Bluebird-Aerospace/versor-lite/kicad_files/versorlite.kicad_pcb

## KiCad design kicad_files/versorlite.kicad_pcb (2026-05-29)

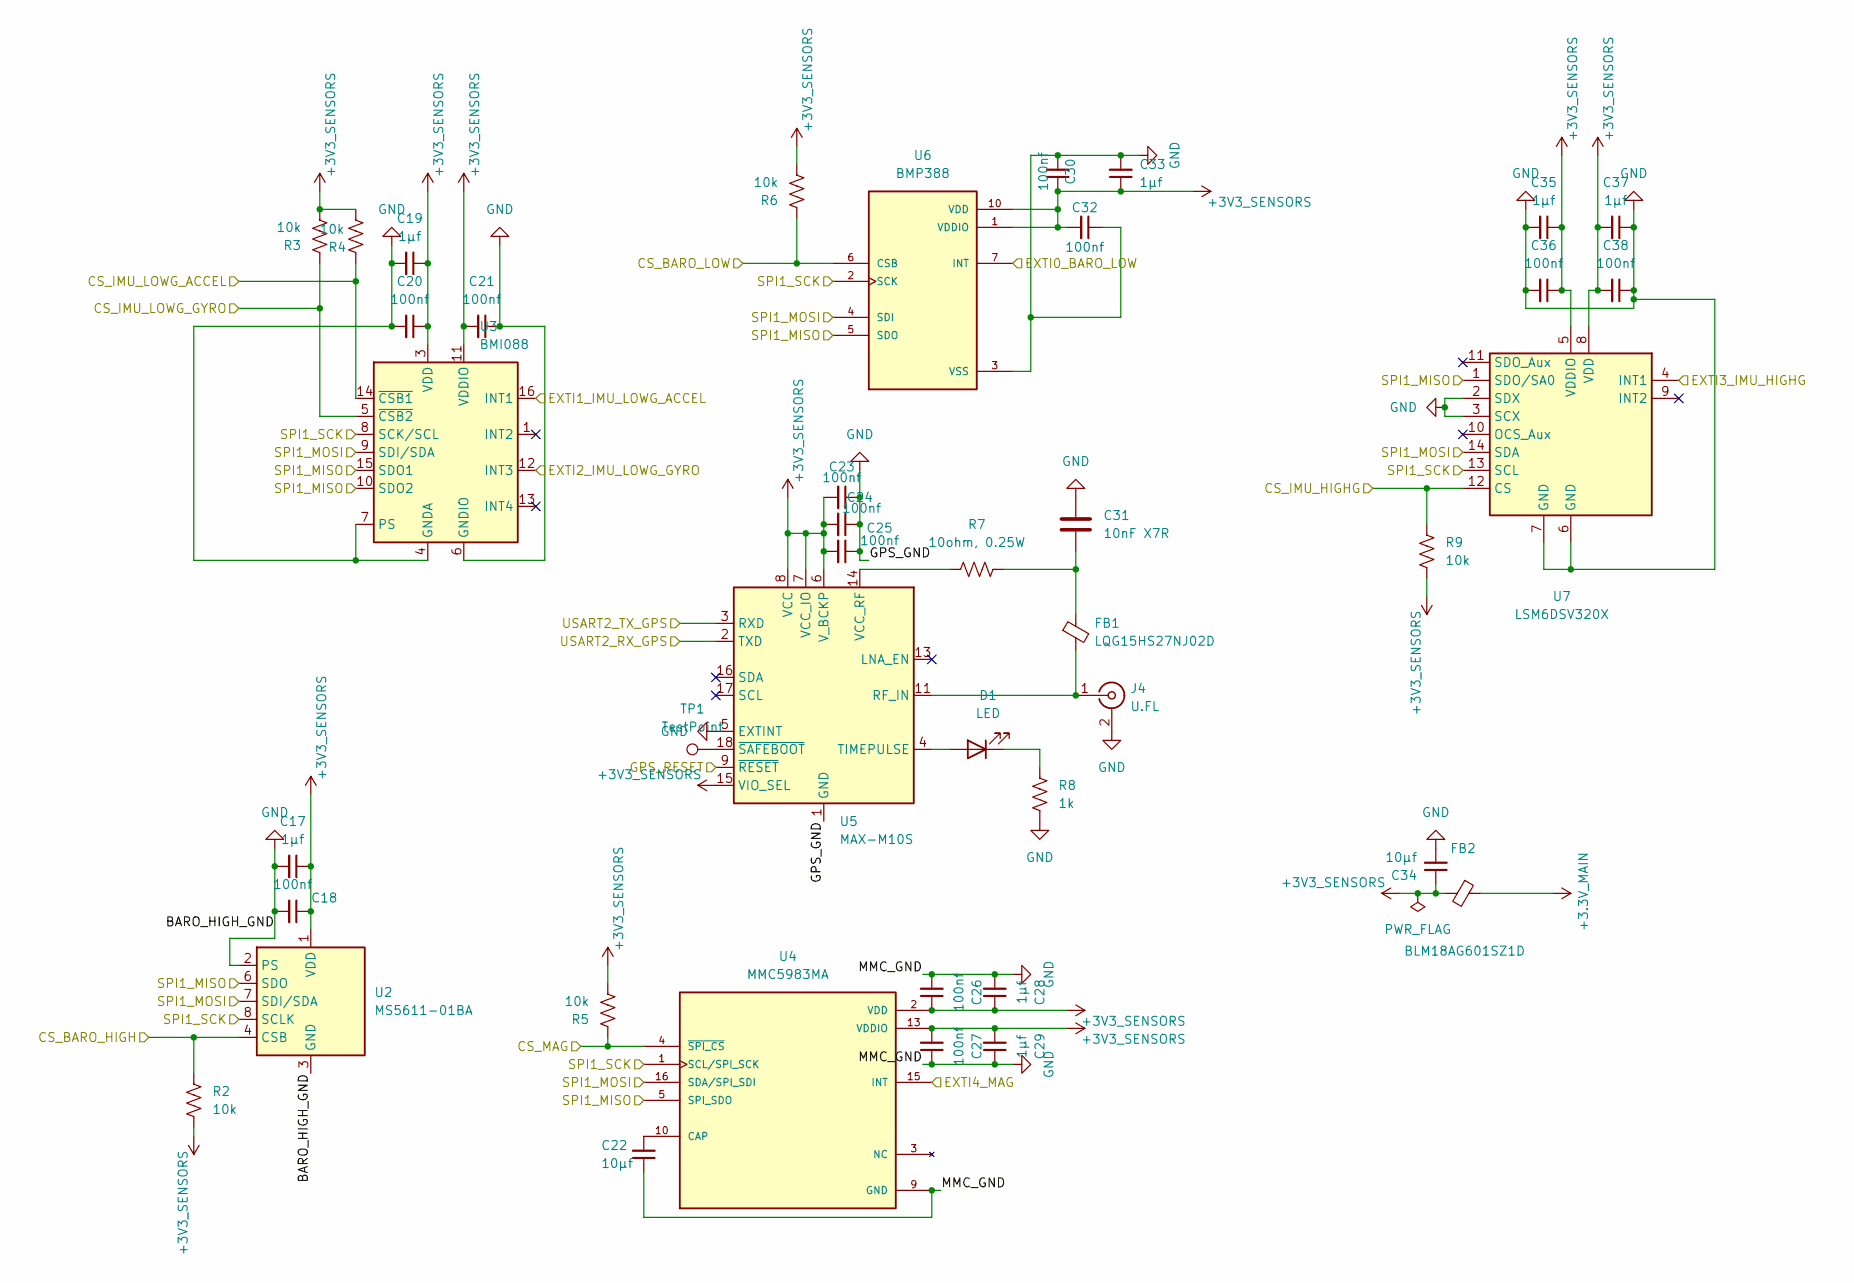
[picture p1: schematic sensors.kicad_sch]

Parts:
C17, C19, C28, C29, C33, C35, C37: 1μf; C_0402_1005Metric
C18, C20, C21, C23, C24, C25, C26, C27, C30, C32, C36, C38: 100nf; C_0402_1005Metric
C22, C34: 10μf; C_0805_2012Metric
C31: 10nF X7R; C_0402_1005Metric
D1: LED; LED_0603_1608Metric
FB1: LQG15HS27NJ02D; L_0402_1005Metric
FB2: BLM18AG601SZ1D; L_0603_1608Metric
J4: U.FL; U.FL_Hirose_U.FL-R-SMT-1_Vertical; LCSC C5137195
R2, R3, R4, R5, R6, R9: 10k; R_0402_1005Metric
R7: 10ohm, 0.25W; R_1206_3216Metric
R8: 1k; R_0603_1608Metric
TP1: TestPoint; TestPoint_Pad_D1.0mm
U2: MS5611-01BA; LGA-8_3x5mm_P1.25mm
U3: BMI088; Bosch_LGA-16_4.5x3mm_P0.5mm_LayoutBorder7x1y_ClockwisePinNu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
U4: MMC5983MA; PQFN50P300X300X100-16N; PARTREV A
U5: MAX-M10S; ublox_MAX
U6: BMP388; PARTREV 1.1
U7: LSM6DSV320X; LGA-14_3x2.5mm_P0.5mm_LayoutBorder3x4y

Connections:
+3.3V_MAIN: FB2.1; also elsewhere on the board
+3V3_SENSORS: C17.1, C18.1, C19.1, C20.1, C21.2, C23.2, C24.2, C25.2, C26.1, C27.2, C28.1, C29.2, C30.1, C32.2, C33.1, C34.1, C35.1, C36.1, C37.2, C38.2, FB2.2, R2.2, R3.2, R4.2, R5.2, R6.2, R9.2, U2.1 (VDD), U3.3 (VDD), U3.11 (VDDIO), U4.2 (VDD), U4.13 (VDDIO), U5.6 (V_BCKP), U5.7 (VCC_IO), U5.8 (VCC), U5.15 (VIO_SEL), U6.1 (VDDIO), U6.10 (VDD), U7.5 (VDDIO), U7.8 (VDD)
/MCU/CS_BARO_HIGH: R2.1, U2.4 (CSB), U2.5 (CSB); also elsewhere on the board
/MCU/CS_BARO_LOW: R6.1, U6.6 (CSB); also elsewhere on the board
/MCU/CS_IMU_HIGHG: R9.1, U7.12 (CS); also elsewhere on the board
/MCU/CS_IMU_LOWG_ACCEL: R4.1, U3.14 (~CSB1); also elsewhere on the board
/MCU/CS_IMU_LOWG_GYRO: R3.1, U3.5 (~CSB2); also elsewhere on the board
/MCU/CS_MAG: R5.1, U4.4 (~SPI_CS); also elsewhere on the board
/MCU/EXTI0_BARO_LOW: U6.7 (INT); also elsewhere on the board
/MCU/EXTI1_IMU_LOWG_ACCEL: U3.16 (INT1); also elsewhere on the board
/MCU/EXTI2_IMU_LOWG_GYRO: U3.12 (INT3); also elsewhere on the board
/MCU/EXTI3_IMU_HIGHG: U7.4 (INT1); also elsewhere on the board
/MCU/EXTI4_MAG: U4.15 (INT); also elsewhere on the board
/MCU/GPS_RESET: U5.9 (~RESET); also elsewhere on the board
/MCU/SPI1_MISO: U2.6 (SDO), U3.10 (SDO2), U3.15 (SDO1), U4.5 (SPI_SDO), U6.5 (SDO), U7.1 (SDO/SA0); also elsewhere on the board
/MCU/SPI1_MOSI: U2.7 (SDI/SDA), U3.9 (SDI/SDA), U4.16 (SDA/SPI_SDI), U6.4 (SDI), U7.14 (SDA); also elsewhere on the board
/MCU/SPI1_SCK: U2.8 (SCLK), U3.8 (SCK/SCL), U4.1 (SCL/SPI_SCK), U6.2 (SCK), U7.13 (SCL); also elsewhere on the board
/MCU/USART2_RX_GPS: U5.2 (TXD); also elsewhere on the board
/MCU/USART2_TX_GPS: U5.3 (RXD); also elsewhere on the board
GND: C17.2, C18.2, C19.2, C20.2, C21.1, C22.1, C23.1, C24.1, C25.1, C26.2, C27.1, C28.2, C29.1, C30.2, C31.1, C32.1, C33.2, C34.2, C35.2, C36.2, C37.1, C38.1, J4.2 (Ext), R8.2, U2.2 (PS), U2.3 (GND), U3.2 (GNDA), U3.4 (GNDA), U3.6 (GNDIO), U3.7 (PS), U4.9 (GND), U4.11 (GND), U5.1 (GND), U5.5 (EXTINT), U5.10 (GND), U5.12 (GND), U6.3 (VSS), U6.8 (VSS), U6.9 (VSS), U7.2 (SDX), U7.3 (SCX), U7.6 (GND), U7.7 (GND); also elsewhere on the board
unnamed: C31.2, FB1.1, R7.2
unnamed: D1.2 (A), U5.4 (TIMEPULSE)
unnamed: D1.1 (K), R8.1
unnamed: FB1.2, J4.1 (In), U5.11 (RF_IN)
unnamed: C22.2, U4.10 (CAP)
unnamed: R7.1, U5.14 (VCC_RF)
unnamed: TP1.1 (1_1), U5.18 (~SAFEBOOT)

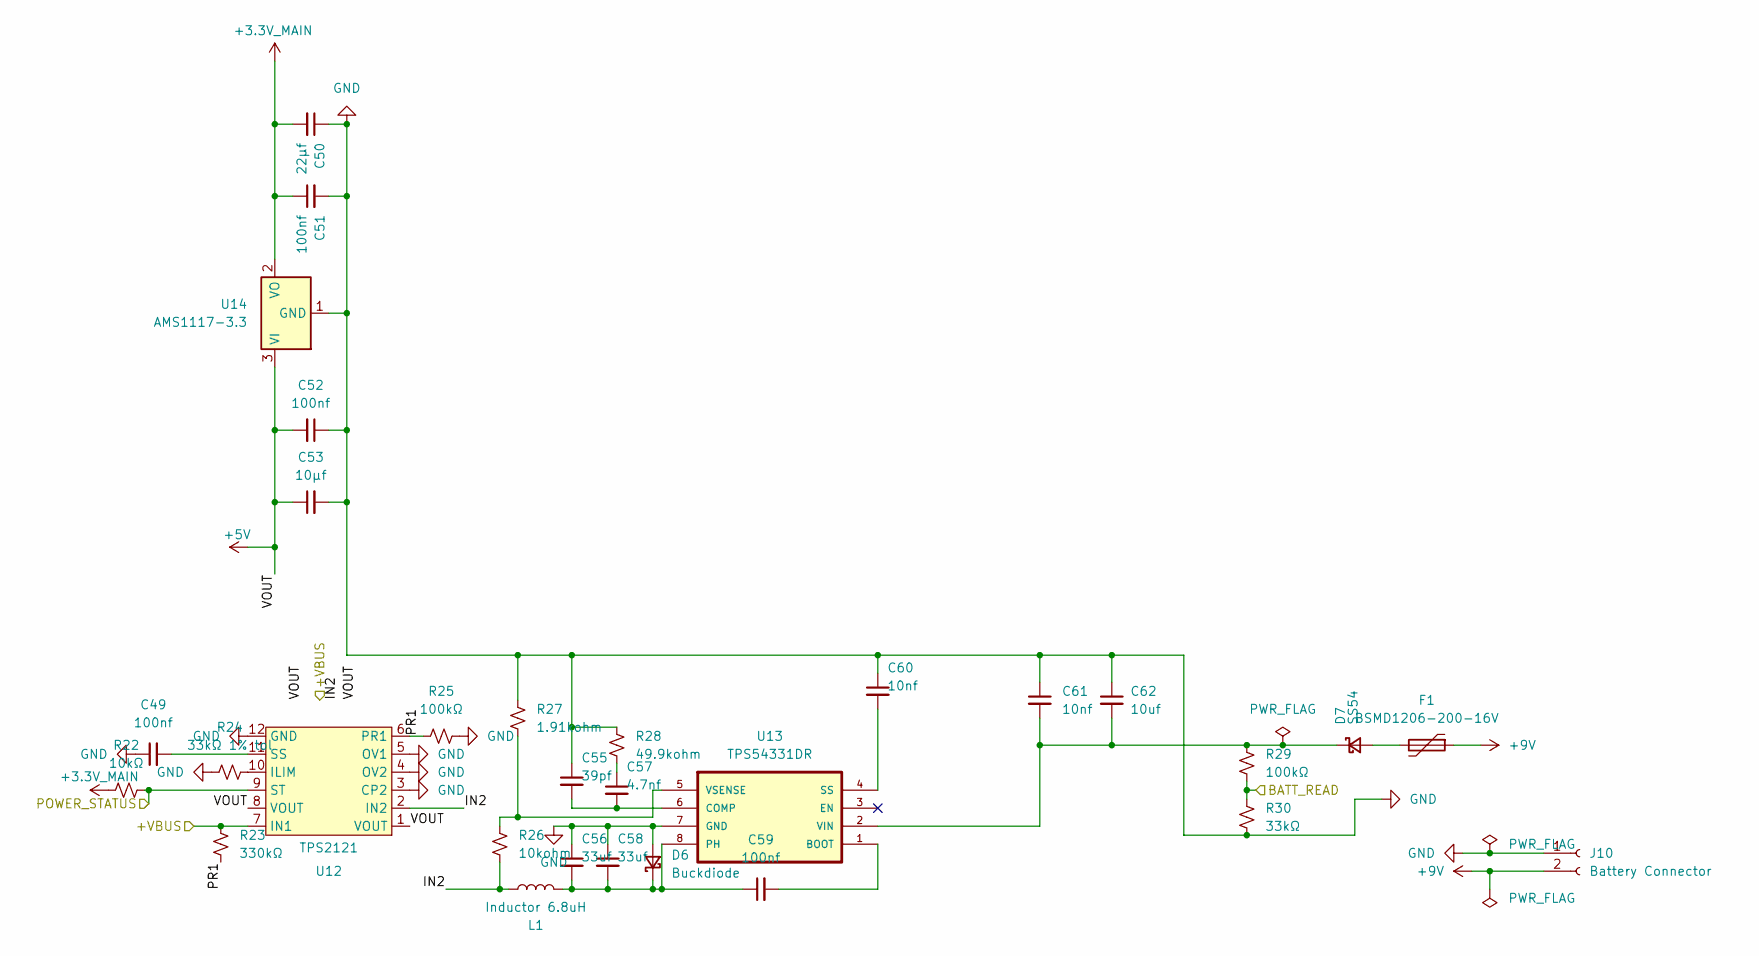
[picture p2: schematic power.kicad_sch]

Parts:
C49, C51, C52, C59: 100nf; C_0402_1005Metric
C50: 22μf; C_0805_2012Metric
C53: 10μf; C_0805_2012Metric
C55: 39pf; C_0402_1005Metric
C56, C58: 33uf; C_0805_2012Metric
C57: 4.7nf; C_0402_1005Metric
C60, C61: 10nf; C_0402_1005Metric
C62: 10uf; C_0805_2012Metric
D6: Buckdiode; D_SMA
D7: SS54; D_SMA
F1: BSMD1206-200-16V; Fuse_1206_3216Metric
J10: Battery Connector; AMASS_XT30U-F_1x02_P5.0mm_Vertical
L1: Inductor 6.8uH; L_Coilcraft_XxL4030
R22: 10kΩ; R_0402_1005Metric
R23: 330kΩ; R_0402_1005Metric
R24: 33kΩ 1% tol; R_0402_1005Metric
R25: 100kΩ; R_0402_1005Metric
R26: 10kohm; R_0402_1005Metric
R27: 1.91kohm; R_0402_1005Metric
R28: 49.9kohm; R_0402_1005Metric
R29: 100kΩ; R_0603_1608Metric
R30: 33kΩ; R_0603_1608Metric
U12: TPS2121; IC_TPS2121RUXR
U13: TPS54331DR; SOIC127P599X175-8N
U14: AMS1117-3.3; SOT-223-3_TabPin2

Connections:
+3.3V_MAIN: C50.2, C51.1, R22.1, U14.2 (VO); also elsewhere on the board
+5V: C52.2, C53.1, U12.1 (VOUT), U12.1_1 (TV), U12.8 (VOUT), U12.8_1 (TV), U14.3 (VI); also elsewhere on the board
+9V: F1.1, J10.2; also elsewhere on the board
/MCU/BATT_READ: R29.2, R30.1; also elsewhere on the board
/MCU/POWER_STATUS: R22.2, U12.9 (ST); also elsewhere on the board
/Power/+VBUS: R23.2, U12.7 (IN1), U12.7_1 (TV); also elsewhere on the board
/Power/IN2: L1.1, R26.2, U12.2 (IN2), U12.2_1 (TV)
/Power/PR1: R23.1, R25.1, U12.6 (PR1)
GND: C49.1, C50.1, C51.2, C52.1, C53.2, C55.1, C56.1, C58.1, C60.1, C61.1, C62.1, D6.2 (A), J10.1, R24.1, R25.2, R27.1, R28.1, R30.2, U12.3 (CP2), U12.4 (OV2), U12.5 (OV1), U12.12 (GND), U13.7 (GND), U14.1 (GND); also elsewhere on the board
unnamed: C57.1, R28.2
unnamed: C56.2, C58.2, C59.1, D6.1 (K), L1.2, U13.8 (PH)
unnamed: D7.2 (A), F1.2
unnamed: C61.2, C62.2, D7.1 (K), R29.1, U13.2 (VIN)
unnamed: R24.2, U12.10 (ILIM)
unnamed: C49.2, U12.11 (SS)
unnamed: C59.2, U13.1 (BOOT)
unnamed: C55.2, C57.2, U13.6 (COMP)
unnamed: C60.2, U13.4 (SS)
unnamed: R26.1, R27.2, U13.5 (VSENSE)

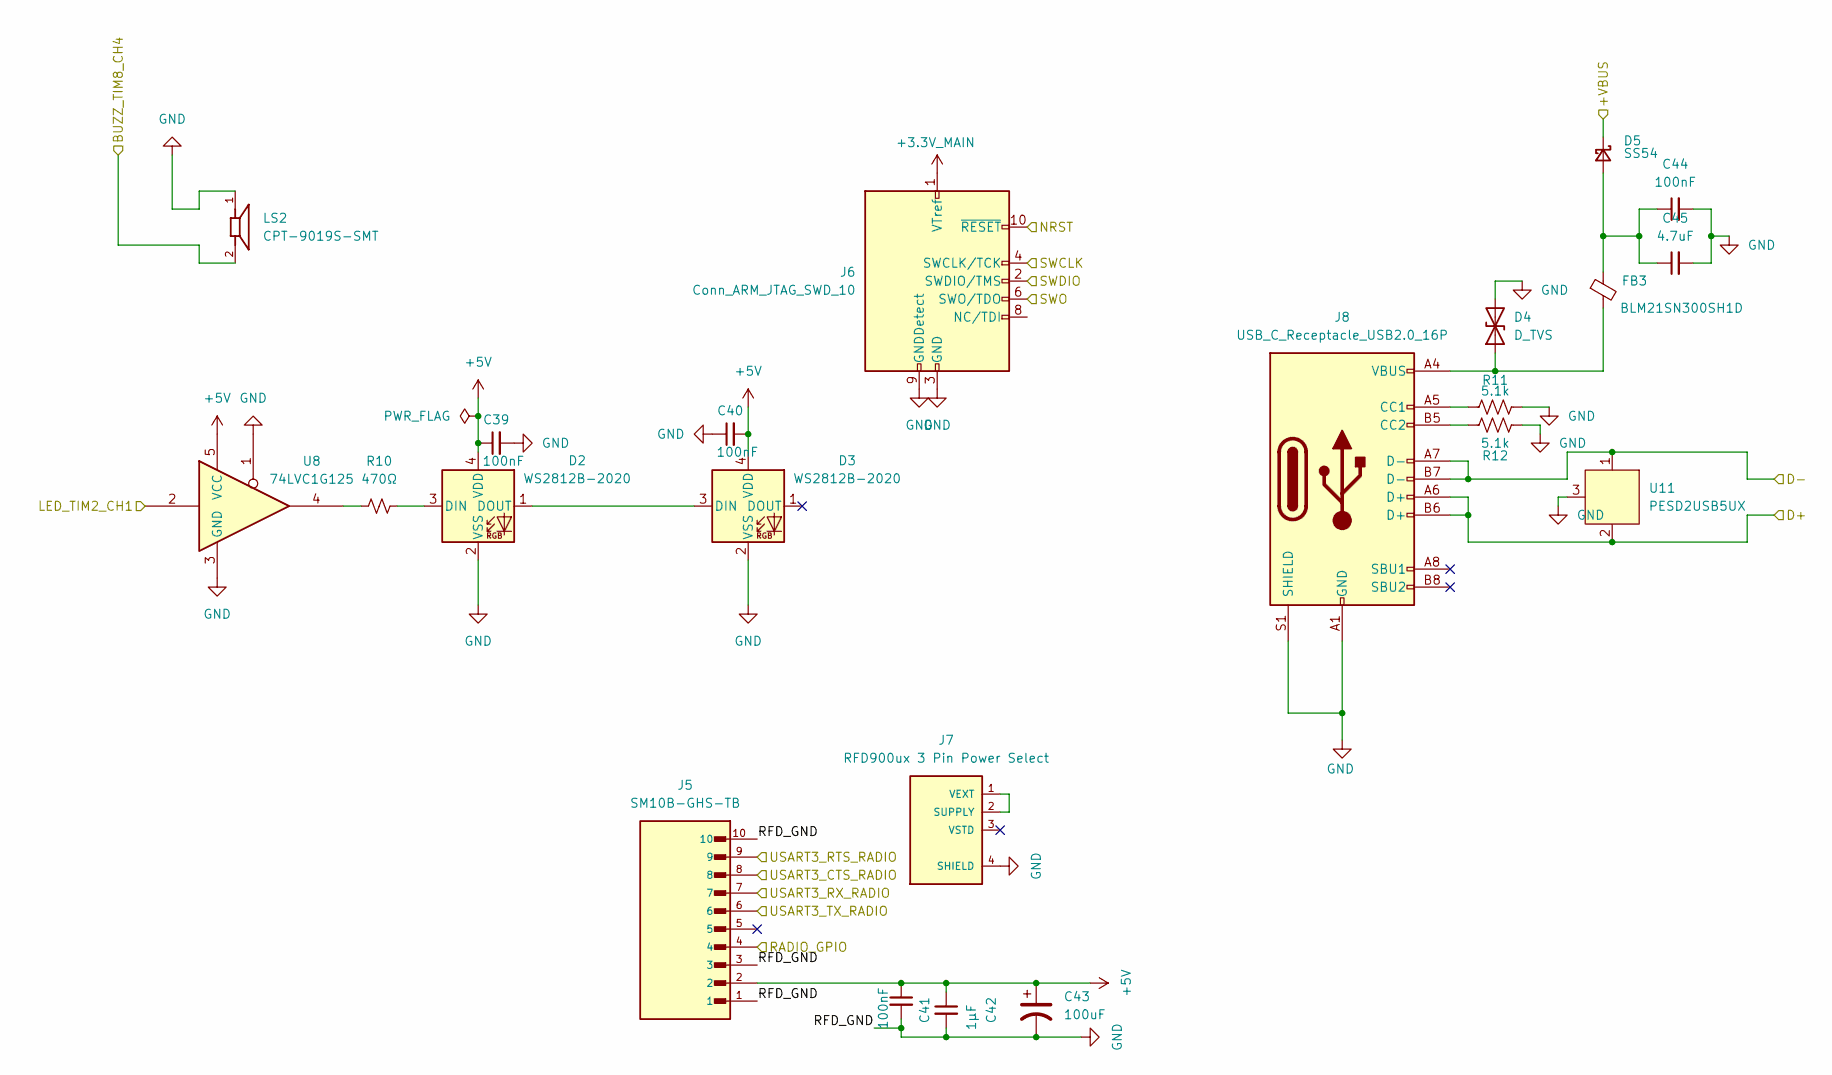
[picture p3: schematic telemetry.kicad_sch]

Parts:
C39, C40, C41, C44: 100nF; C_0402_1005Metric
C42: 1μF; C_0402_1005Metric
C43: 100uF; CP_EIA-3528-21_Kemet-B
C45: 4.7uF; C_0603_1608Metric
D2, D3: WS2812B-2020; LED_WS2812B-2020_PLCC4_2.0x2.0mm
D4: D_TVS; D_SOD-882
D5: SS54; D_SMA
FB3: BLM21SN300SH1D; L_0805_2012Metric
J5: SM10B-GHS-TB; JST_SM10B-GHS-TB
J6: Conn_ARM_JTAG_SWD_10; PinHeader_2x05_P1.27mm_Vertical
J7: RFD900ux 3 Pin Power Select; CONN_BM03B-GHS-TBT_LF__SN__N_
J8: USB_C_Receptacle_USB2.0_16P; USB_C_Receptacle_GCT_USB4105-xx-A_16P_TopMnt_Horizontal
LS2: CPT-9019S-SMT; CUI_CPT-9019S-SMT; PART_REV 1.0
R10: 470Ω; R_0402_1005Metric
R11, R12: 5.1k; R_0402_1005Metric
U8: 74LVC1G125; SOT-23-5
U11: PESD2USB5UX; TSOT-23

Connections:
+3.3V_MAIN: J6.1 (VTref); also elsewhere on the board
+5V: C39.1, C40.2, C41.1, C42.1, C43.1, D2.4 (VDD), D3.4 (VDD), J5.2, U8.5 (VCC); also elsewhere on the board
/MCU/BUZZ_TIM8_CH4: LS2.2; also elsewhere on the board
/MCU/D+: J8.A6 (D+), J8.B6 (D+), U11.2; also elsewhere on the board
/MCU/D-: J8.A7 (D-), J8.B7 (D-), U11.1; also elsewhere on the board
/MCU/LED_TIM2_CH1: U8.2; also elsewhere on the board
/MCU/NRST: J6.10 (~RESET); also elsewhere on the board
/MCU/RADIO_GPIO: J5.4; also elsewhere on the board
/MCU/SWCLK: J6.4 (SWCLK/TCK); also elsewhere on the board
/MCU/SWDIO: J6.2 (SWDIO/TMS); also elsewhere on the board
/MCU/SWO: J6.6 (SWO/TDO); also elsewhere on the board
/MCU/USART3_CTS_RADIO: J5.8; also elsewhere on the board
/MCU/USART3_RTS_RADIO: J5.9; also elsewhere on the board
/MCU/USART3_RX_RADIO: J5.7; also elsewhere on the board
/MCU/USART3_TX_RADIO: J5.6; also elsewhere on the board
/Power/+VBUS: D5.1 (K); also elsewhere on the board
GND: C39.2, C40.1, C41.2, C42.2, C43.2, C44.2, C45.2, D2.2 (VSS), D3.2 (VSS), D4.2 (A2), J5.1, J5.3, J5.10, J6.3 (GND), J6.5 (GND), J6.9 (GNDDetect), J7.4 (SHIELD), J7.5 (SHIELD), J8.A1 (GND), J8.A12 (GND), J8.B1 (GND), J8.B12 (GND), J8.S1 (SHIELD), LS2.1, R11.2, R12.2, U8.1, U8.3 (GND), U11.3; also elsewhere on the board
unnamed: D2.3 (DIN), R10.2
unnamed: D2.1 (DOUT), D3.3 (DIN)
unnamed: D4.1 (A1), FB3.2, J8.A4 (VBUS), J8.A9 (VBUS), J8.B4 (VBUS), J8.B9 (VBUS)
unnamed: C44.1, C45.1, D5.2 (A), FB3.1
unnamed: J7.1 (VEXT), J7.2 (SUPPLY)
unnamed: J8.A5 (CC1), R11.1
unnamed: J8.B5 (CC2), R12.1
unnamed: R10.1, U8.4

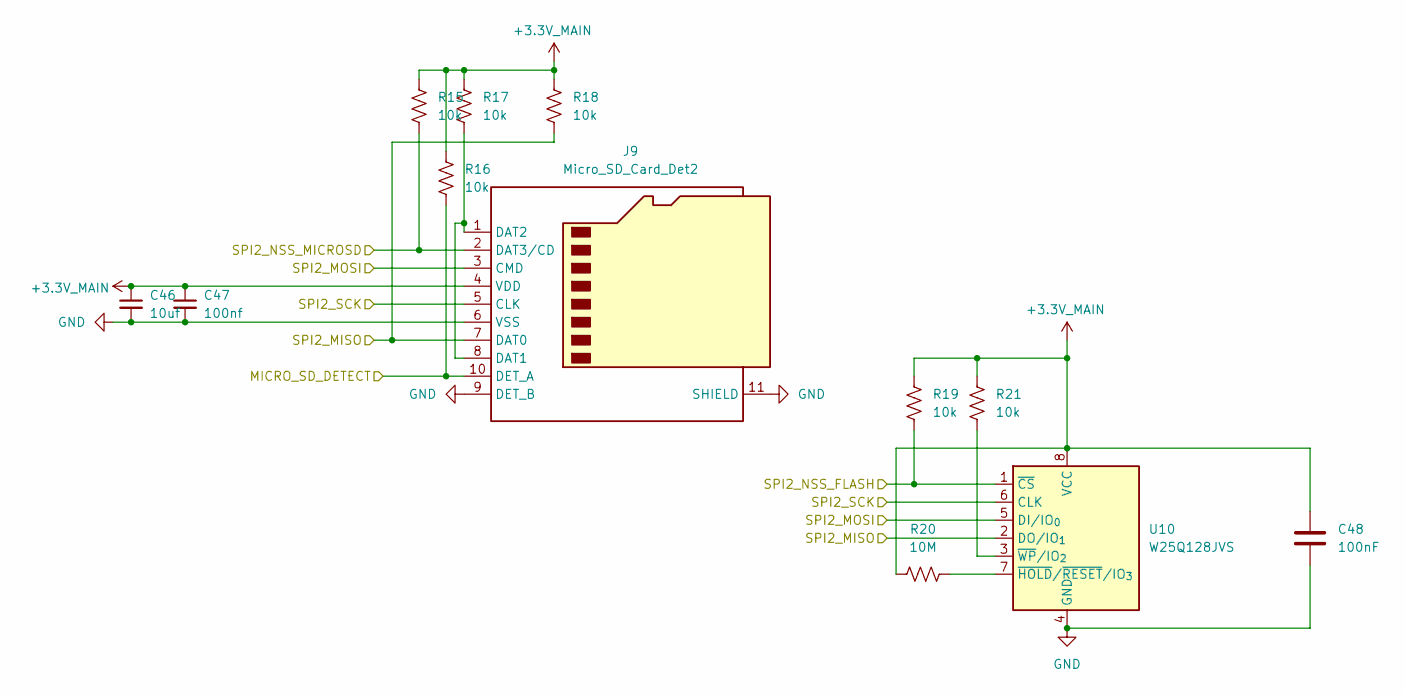
[picture p4: schematic storage.kicad_sch]

Parts:
C46: 10uf; C_0805_2012Metric
C47: 100nf; C_0402_1005Metric
C48: 100nF; C_0402_1005Metric
J9: Micro_SD_Card_Det2; microSD_HC_Molex_104031-0811
R15, R16, R17, R18, R19, R21: 10k; R_0402_1005Metric
R20: 10M; R_0603_1608Metric
U10: W25Q128JVS; SOIC-8_5.3x5.3mm_P1.27mm

Connections:
+3.3V_MAIN: C46.1, C47.1, C48.1, J9.4 (VDD), R15.1, R16.1, R17.2, R18.2, R19.1, R20.1, R21.1, U10.8 (VCC); also elsewhere on the board
/MCU/MICRO_SD_DETECT: J9.10 (DET_A), R16.2; also elsewhere on the board
/MCU/SPI2_MISO: J9.7 (DAT0), R18.1, U10.2 (DO/IO_{1}); also elsewhere on the board
/MCU/SPI2_MOSI: J9.3 (CMD), U10.5 (DI/IO_{0}); also elsewhere on the board
/MCU/SPI2_NSS_FLASH: R19.2, U10.1 (~CS); also elsewhere on the board
/MCU/SPI2_NSS_MICROSD: J9.2 (DAT3/CD), R15.2; also elsewhere on the board
/MCU/SPI2_SCK: J9.5 (CLK), U10.6 (CLK); also elsewhere on the board
GND: C46.2, C47.2, C48.2, J9.6 (VSS), J9.9 (DET_B), J9.11 (SHIELD), U10.4 (GND); also elsewhere on the board
unnamed: J9.1 (DAT2), J9.8 (DAT1), R17.1
unnamed: R20.2, U10.7 (~HOLD/~RESET/IO_{3})
unnamed: R21.2, U10.3 (~WP/IO_{2})

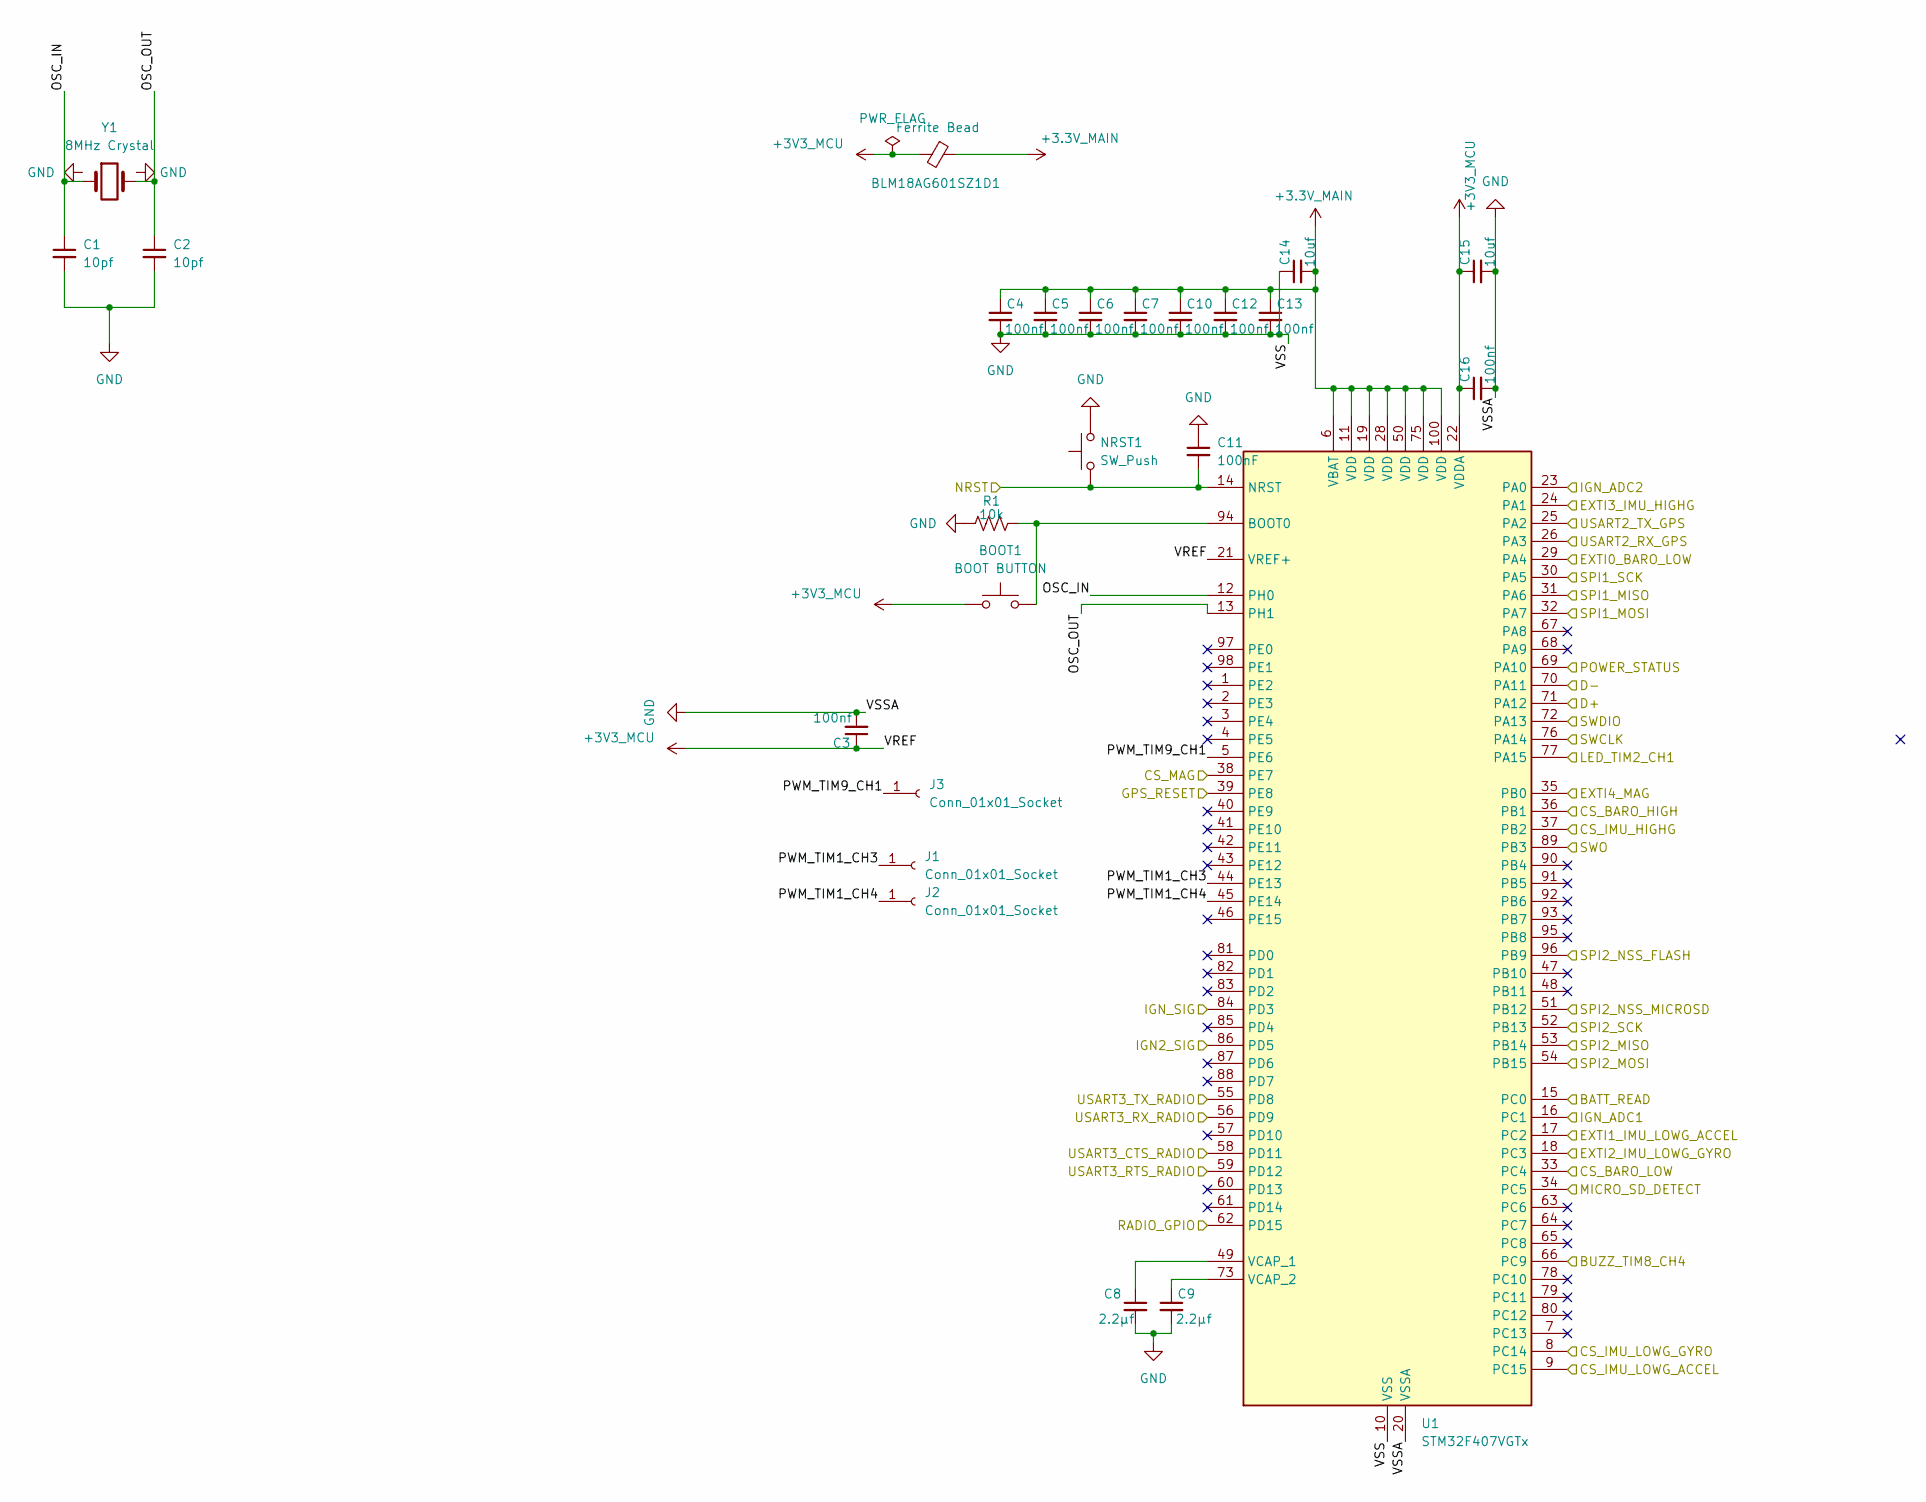
[picture p5: schematic MCU.kicad_sch]

Parts:
BLM18AG601SZ1D1: Ferrite Bead; L_0603_1608Metric
BOOT1: BOOT BUTTON; SW_SPST_PTS810
C1, C2: 10pf; C_0402_1005Metric
C3, C4, C5, C6, C7, C10, C12, C13, C16: 100nf; C_0402_1005Metric
C8, C9: 2.2µf; C_0603_1608Metric
C11: 100nF; C_0402_1005Metric
C14, C15: 10uf; C_0805_2012Metric
J1, J2, J3: Conn_01x01_Socket; SolderWire-0.5sqmm_1x01_D0.9mm_OD2.1mm
NRST1: SW_Push; SW_SPST_PTS810
R1: 10k; R_0402_1005Metric
U1: STM32F407VGTx; LQFP-100_14x14mm_P0.5mm
Y1: 8MHz Crystal; Crystal_SMD_3225-4Pin_3.2x2.5mm

Connections:
+3.3V_MAIN: BLM18AG601SZ1D1.1, C4.1, C5.1, C6.1, C7.1, C10.1, C12.1, C13.1, C14.2, U1.6 (VBAT), U1.11 (VDD), U1.19 (VDD), U1.28 (VDD), U1.50 (VDD), U1.75 (VDD), U1.100 (VDD); also elsewhere on the board
+3V3_MCU: BLM18AG601SZ1D1.2, BOOT1.1, C3.1, C15.1, C16.1, U1.21 (VREF+), U1.22 (VDDA)
/MCU/BATT_READ: U1.15 (PC0); also elsewhere on the board
/MCU/BUZZ_TIM8_CH4: U1.66 (PC9); also elsewhere on the board
/MCU/CS_BARO_HIGH: U1.36 (PB1); also elsewhere on the board
/MCU/CS_BARO_LOW: U1.33 (PC4); also elsewhere on the board
/MCU/CS_IMU_HIGHG: U1.37 (PB2); also elsewhere on the board
/MCU/CS_IMU_LOWG_ACCEL: U1.9 (PC15); also elsewhere on the board
/MCU/CS_IMU_LOWG_GYRO: U1.8 (PC14); also elsewhere on the board
/MCU/CS_MAG: U1.38 (PE7); also elsewhere on the board
/MCU/D+: U1.71 (PA12); also elsewhere on the board
/MCU/D-: U1.70 (PA11); also elsewhere on the board
/MCU/EXTI0_BARO_LOW: U1.29 (PA4); also elsewhere on the board
/MCU/EXTI1_IMU_LOWG_ACCEL: U1.17 (PC2); also elsewhere on the board
/MCU/EXTI2_IMU_LOWG_GYRO: U1.18 (PC3); also elsewhere on the board
/MCU/EXTI3_IMU_HIGHG: U1.24 (PA1); also elsewhere on the board
/MCU/EXTI4_MAG: U1.35 (PB0); also elsewhere on the board
/MCU/GPS_RESET: U1.39 (PE8); also elsewhere on the board
/MCU/IGN2_SIG: U1.86 (PD5); also elsewhere on the board
/MCU/IGN_ADC1: U1.16 (PC1); also elsewhere on the board
/MCU/IGN_ADC2: U1.23 (PA0); also elsewhere on the board
/MCU/IGN_SIG: U1.84 (PD3); also elsewhere on the board
/MCU/LED_TIM2_CH1: U1.77 (PA15); also elsewhere on the board
/MCU/MICRO_SD_DETECT: U1.34 (PC5); also elsewhere on the board
/MCU/NRST: C11.2, NRST1.1, U1.14 (NRST); also elsewhere on the board
/MCU/OSC_IN: C1.1, U1.12 (PH0), Y1.1
/MCU/OSC_OUT: C2.1, U1.13 (PH1), Y1.3
/MCU/POWER_STATUS: U1.69 (PA10); also elsewhere on the board
/MCU/PWM_TIM1_CH3: J1.1 (Pin_1_1), U1.44 (PE13)
/MCU/PWM_TIM1_CH4: J2.1 (Pin_1_1), U1.45 (PE14)
/MCU/PWM_TIM9_CH1: J3.1 (Pin_1_1), U1.5 (PE6)
/MCU/RADIO_GPIO: U1.62 (PD15); also elsewhere on the board
/MCU/SPI1_MISO: U1.31 (PA6); also elsewhere on the board
/MCU/SPI1_MOSI: U1.32 (PA7); also elsewhere on the board
/MCU/SPI1_SCK: U1.30 (PA5); also elsewhere on the board
/MCU/SPI2_MISO: U1.53 (PB14); also elsewhere on the board
/MCU/SPI2_MOSI: U1.54 (PB15); also elsewhere on the board
/MCU/SPI2_NSS_FLASH: U1.96 (PB9); also elsewhere on the board
/MCU/SPI2_NSS_MICROSD: U1.51 (PB12); also elsewhere on the board
/MCU/SPI2_SCK: U1.52 (PB13); also elsewhere on the board
/MCU/SWCLK: U1.76 (PA14); also elsewhere on the board
/MCU/SWDIO: U1.72 (PA13); also elsewhere on the board
/MCU/SWO: U1.89 (PB3); also elsewhere on the board
/MCU/USART2_RX_GPS: U1.26 (PA3); also elsewhere on the board
/MCU/USART2_TX_GPS: U1.25 (PA2); also elsewhere on the board
/MCU/USART3_CTS_RADIO: U1.58 (PD11); also elsewhere on the board
/MCU/USART3_RTS_RADIO: U1.59 (PD12); also elsewhere on the board
/MCU/USART3_RX_RADIO: U1.56 (PD9); also elsewhere on the board
/MCU/USART3_TX_RADIO: U1.55 (PD8); also elsewhere on the board
GND: C1.2, C2.2, C3.2, C4.2, C5.2, C6.2, C7.2, C8.2, C9.2, C10.2, C11.1, C12.2, C13.2, C14.1, C15.2, C16.2, NRST1.2, R1.1, U1.10 (VSS), U1.20 (VSSA), U1.27 (VSS), U1.74 (VSS), U1.99 (VSS), Y1.2, Y1.4; also elsewhere on the board
unnamed: BOOT1.2, R1.2, U1.94 (BOOT0)
unnamed: C8.1, U1.49 (VCAP_1)
unnamed: C9.1, U1.73 (VCAP_2)

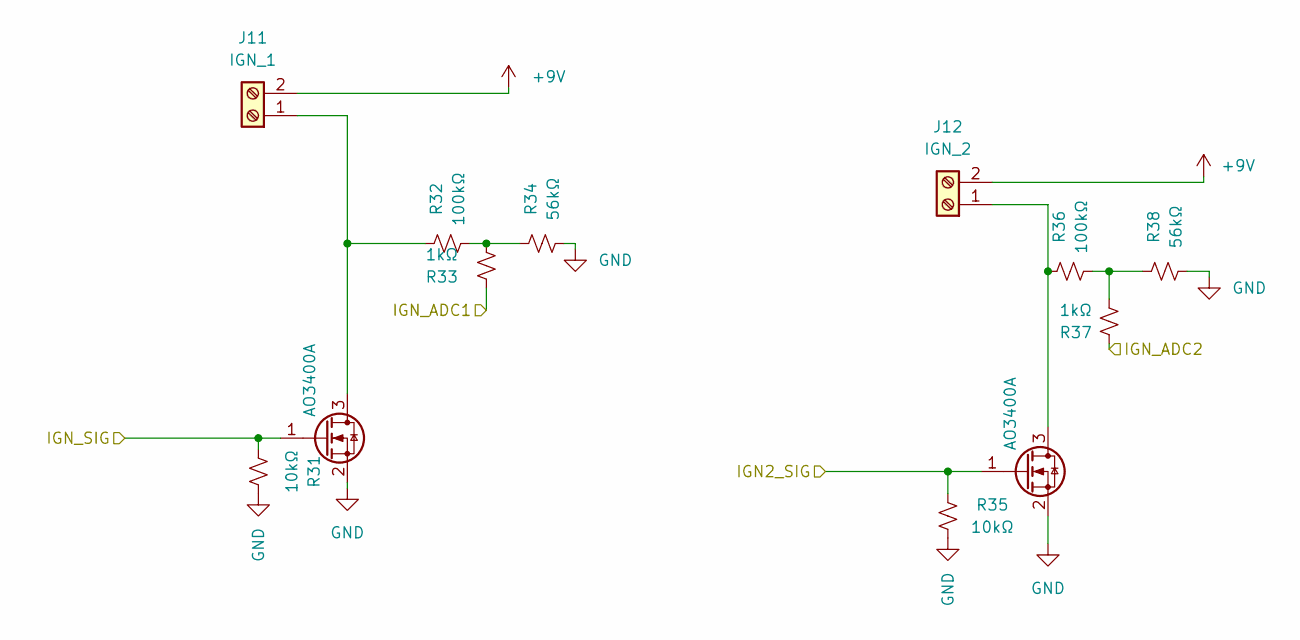
[picture p6: schematic pyro.kicad_sch]

Parts:
J11: IGN_1; SolderWire-0.5sqmm_1x02_P4.6mm_D0.9mm_OD2.1mm
J12: IGN_2; SolderWire-0.5sqmm_1x02_P4.6mm_D0.9mm_OD2.1mm
Q1, Q2: AO3400A; SOT-23
R31, R35: 10kΩ; R_0402_1005Metric
R32, R36: 100kΩ; R_0402_1005Metric
R33, R37: 1kΩ; R_0402_1005Metric
R34, R38: 56kΩ; R_0402_1005Metric

Connections:
+9V: J11.2, J12.2; also elsewhere on the board
/MCU/IGN2_SIG: Q2.1 (G), R35.1; also elsewhere on the board
/MCU/IGN_ADC1: R33.1; also elsewhere on the board
/MCU/IGN_ADC2: R37.1; also elsewhere on the board
/MCU/IGN_SIG: Q1.1 (G), R31.1; also elsewhere on the board
GND: Q1.2 (S), Q2.2 (S), R31.2, R34.2, R35.2, R38.2; also elsewhere on the board
unnamed: J11.1, Q1.3 (D), R32.1
unnamed: J12.1, Q2.3 (D), R36.1
unnamed: R32.2, R33.2, R34.1
unnamed: R36.2, R37.2, R38.1

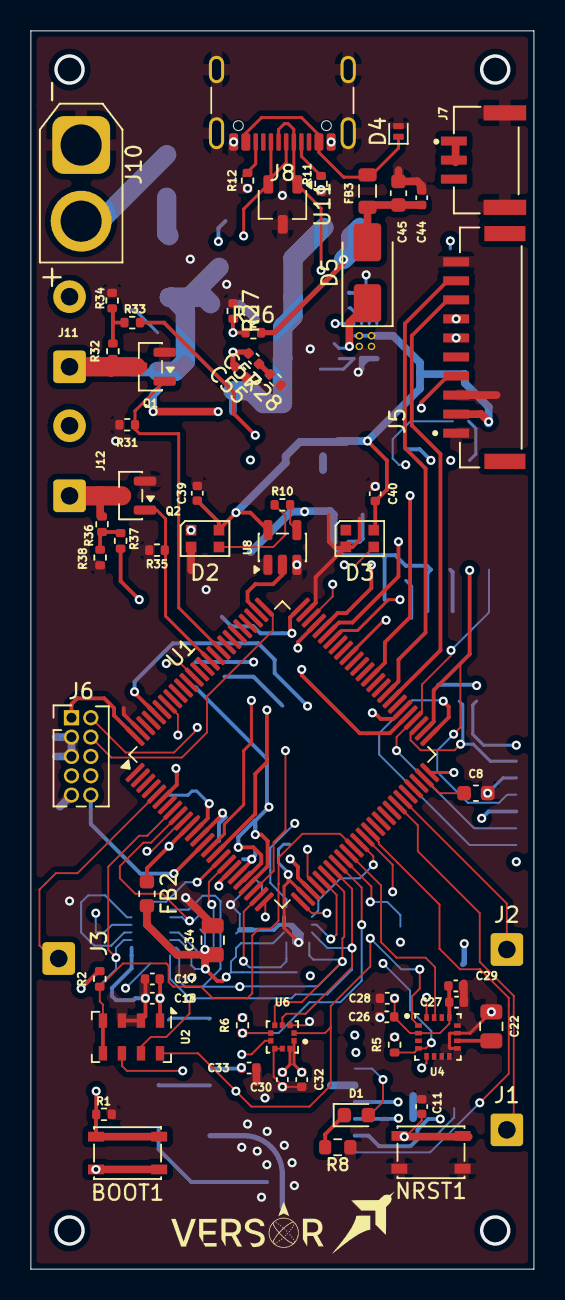
[picture p7: board versorlite.kicad_pcb from above]

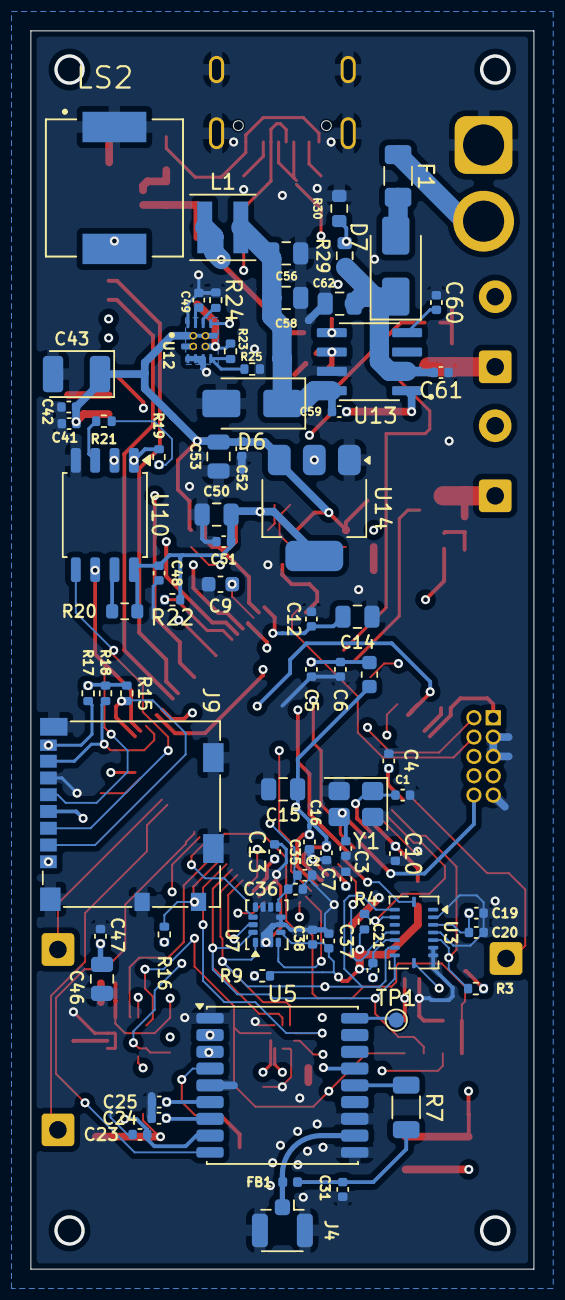
[picture p8: board versorlite.kicad_pcb from below]

Board: 4 copper layers, 33.0 x 81.3 mm, 142 parts (77 on the bottom side), 91 nets.
