Bluebird-Aerospace/versor-lite/(commit log)

2026-04-22 versor lite copied
    [MCU.kicad_sch, power.kicad_sch, pyro.kicad_sch, sensors.kicad_sch, storage.kicad_sch, telemetry.kicad_sch, versorlite.kicad_pcb, versorlite.kicad_sch]
2026-04-23 add gitignore, rm extra git repo, switch mcu
    [MCU.kicad_sch, power.kicad_sch, pyro.kicad_sch, sensors.kicad_sch, storage.kicad_sch, telemetry.kicad_sch, versorlite.kicad_pcb, versorlite.kicad_sch]
2026-04-23 Fix PCB conflict (pls work)
    [MCU.kicad_sch, versorlite.kicad_pcb]
2026-04-23 reset symbol annotations
    [power.kicad_sch, pyro.kicad_sch, sensors.kicad_sch, storage.kicad_sch, telemetry.kicad_sch]
2026-04-23 Component placement
    [versorlite.kicad_pcb]
2026-04-23 Place components; optimize spacing
    [versorlite.kicad_pcb]
2026-04-23 Flip MMC, pending install
    [versorlite.kicad_pcb]
2026-04-23 Test second GND fill zone
    [versorlite.kicad_pcb]
2026-04-24 make schematic changes
    [MCU.kicad_sch, power.kicad_sch, pyro.kicad_sch, telemetry.kicad_sch]
2026-04-24 Rearrange board for flexibility
    [versorlite.kicad_pcb]
2026-04-24 add footprint
    [power.kicad_sch, sensors.kicad_sch, versorlite.kicad_pcb]
2026-04-25 Rearrange PCB
    [power.kicad_sch, pyro.kicad_sch, versorlite.kicad_pcb]
2026-04-25 Improve spacing on LED and crystal
    [versorlite.kicad_pcb]
2026-04-25 Sensor decoupling capacitor placement
    [versorlite.kicad_pcb]
2026-04-25 More component arrangement
    [versorlite.kicad_pcb]
2026-04-25 Switch buzzer p/n
    No footprint yet
    [telemetry.kicad_sch]
2026-04-25 VBUS, BMS diodes and fuses
    [power.kicad_sch, telemetry.kicad_sch, versorlite.kicad_pcb]
2026-04-26 Test route, place some GND vias
    [versorlite.kicad_pcb]
2026-04-26 Remove obsolete footprint
    [versorlite.kicad_pcb]
2026-04-26 That was NOT supposed to be there
    [versorlite.kicad_pcb]
2026-04-26 GND layer to In2 in stackup
    [versorlite.kicad_pcb]
2026-04-26 Rearrange GNSS and sensors
    [versorlite.kicad_pcb]
2026-04-26 Use more robust terminal block
    [pyro.kicad_sch, sensors.kicad_sch, versorlite.kicad_pcb]
2026-04-27 Repair some traces
    [versorlite.kicad_pcb]
2026-04-27 Place vias for all MCU pins
    [versorlite.kicad_pcb]
2026-04-27 Routing MCU
    [versorlite.kicad_pcb]
2026-04-27 move decaps
    [versorlite.kicad_pcb]
2026-04-28 switch uart, usart, spi lines, adc, pwm
    [MCU.kicad_sch, sensors.kicad_sch, telemetry.kicad_sch, versorlite.kicad_pcb, versorlite.kicad_sch]
2026-04-28 switch sensor interrupts
    [MCU.kicad_sch, versorlite.kicad_pcb]
2026-04-28 changed led, tim
    [MCU.kicad_sch, versorlite.kicad_pcb]
2026-04-28 complete rest of pin swaps
    [MCU.kicad_sch, telemetry.kicad_sch, versorlite.kicad_pcb]
2026-04-28 Route some traces
    [versorlite.kicad_pcb]
2026-04-28 more pcb stuff:
    [versorlite.kicad_pcb]
2026-04-29 Route part 2
    [versorlite.kicad_pcb]
2026-04-29 Complete initial routing
    [versorlite.kicad_pcb]
2026-04-29 oop missed two traces
    [versorlite.kicad_pcb]
2026-04-29 Quick edits, authors
    [versorlite.kicad_pcb]
2026-04-29 Add second pyro channel
    [pyro.kicad_sch, versorlite.kicad_pcb]
2026-04-29 Connect IGN2 signal, rearrange
    [MCU.kicad_sch, pyro.kicad_sch, versorlite.kicad_pcb, versorlite.kicad_sch]
2026-04-30 fix mosfet, power traces, remove capacitors
    [versorlite.kicad_pcb]
2026-04-30 fix mcu decaps
    [power.kicad_sch, versorlite.kicad_pcb]
2026-04-30 Address all non-footprint DRC errors
    [MCU.kicad_sch, power.kicad_sch, versorlite.kicad_pcb]
2026-04-30 Fix silkscreen readability
    [versorlite.kicad_pcb]
2026-04-30 impedance match u.fl line
    [sensors.kicad_sch, versorlite.kicad_pcb]
2026-04-30 fix mcc, gps decaps
    [versorlite.kicad_pcb]
2026-04-30 fix lsm decaps
    [versorlite.kicad_pcb]
2026-05-01 fix unconnected
    [MCU.kicad_sch, sensors.kicad_sch, versorlite.kicad_pcb]
2026-05-01 Move switch back to front
    [versorlite.kicad_pcb]
2026-05-01 add ideal diode
    [power.kicad_sch]
2026-05-01 add dedicated power switching
    [MCU.kicad_sch, power.kicad_sch, pyro.kicad_sch, sensors.kicad_sch, storage.kicad_sch, telemetry.kicad_sch, versorlite.kicad_pcb, versorlite.kicad_sch]
2026-05-01 add ign_adc2
    [MCU.kicad_sch, pyro.kicad_sch, versorlite.kicad_pcb, versorlite.kicad_sch]
2026-05-01 add pwm tht hole
    [MCU.kicad_sch, sensors.kicad_sch, versorlite.kicad_pcb]
2026-05-01 work on pcb drc errors
    [versorlite.kicad_pcb]
2026-05-01 more drc fixing
    [versorlite.kicad_pcb]
2026-05-01 fix more clearance violations
    [versorlite.kicad_pcb]
2026-05-01 drc errors -> 0
    [versorlite.kicad_pcb]
2026-05-01 add two more pwm holes
    [MCU.kicad_sch, versorlite.kicad_pcb]
2026-05-01 fix drc warning errors
    [versorlite.kicad_pcb]
2026-05-01 more drc stuff
    [versorlite.kicad_pcb]
2026-05-01 size polyfuse, final drc stuff
    [MCU.kicad_sch, power.kicad_sch, pyro.kicad_sch, sensors.kicad_sch, storage.kicad_sch, telemetry.kicad_sch, versorlite.kicad_pcb]
2026-05-01 fix broken traces
    [versorlite.kicad_pcb]
2026-05-01 fix thermal vias
    [power.kicad_sch, storage.kicad_sch, versorlite.kicad_pcb]
2026-05-01 fix thermal spoking
    [storage.kicad_sch, versorlite.kicad_pcb]
2026-05-01 Give the switches proper names
    [versorlite.kicad_pcb]
2026-05-01 better schematic labeling so that mr. dzula isn't confused
    [MCU.kicad_sch, power.kicad_sch, sensors.kicad_sch]
2026-05-01 add 3d models
    [telemetry.kicad_sch, versorlite.kicad_pcb]
2026-05-01 impedance matching: update width, ground stitching
    [versorlite.kicad_pcb]
2026-05-02 update impedance matching and gnd stitching according to jlcpcb calculator
    [versorlite.kicad_pcb]
2026-05-02 impedance mistake
    [versorlite.kicad_pcb]
2026-05-02 rm 10pf caps, add 33pf caps close to mcu pins
    [MCU.kicad_sch, versorlite.kicad_pcb]
2026-05-02 replace crystal with smaller, lower esr one, redo footprints, traces
    [MCU.kicad_sch, versorlite.kicad_pcb]
2026-05-02 fix ign
    [pyro.kicad_sch, storage.kicad_sch, versorlite.kicad_pcb]
2026-05-02 fix pyro adc
    [MCU.kicad_sch, power.kicad_sch, pyro.kicad_sch, sensors.kicad_sch, storage.kicad_sch, telemetry.kicad_sch, versorlite.kicad_pcb]
2026-05-02 connect pyro to fuse
    [power.kicad_sch, versorlite.kicad_pcb]
2026-05-02 more jlcpcb, change jst gh header
    [telemetry.kicad_sch, versorlite.kicad_pcb]
2026-05-02 Curve GPS trace, fix DRC
    [versorlite.kicad_pcb]
2026-05-04 fix pyro channel
    [pyro.kicad_sch]
2026-05-04 more jlcpcb parts added
    [versorlite.kicad_pcb]
2026-05-04 Fix some alignments
    [versorlite.kicad_pcb]
2026-05-04 switch buck converter
    [power.kicad_sch]
2026-05-04 Adjust more spacing
    [versorlite.kicad_pcb]
2026-05-04 Quick fix on some routing
    [versorlite.kicad_pcb]
2026-05-04 fix schem for buck conv
    [power.kicad_sch, pyro.kicad_sch, storage.kicad_sch, telemetry.kicad_sch, versorlite.kicad_pcb]
2026-05-05 replace buck converter on pcb
    [power.kicad_sch, versorlite.kicad_pcb]
2026-05-05 fix buzzer
    [MCU.kicad_sch, power.kicad_sch, telemetry.kicad_sch, versorlite.kicad_pcb, versorlite.kicad_sch]
2026-05-05 fill out footprints
    [power.kicad_sch, versorlite.kicad_pcb]
2026-05-05 more footprints
    [versorlite.kicad_pcb]
2026-05-05 JLCPCB LIBRARY IS COMPLETE
    [power.kicad_sch, versorlite.kicad_pcb]
2026-05-05 refill zone
    [versorlite.kicad_pcb]
2026-05-06 replace stm, pin header
    [BOM-versorlite.csv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]
2026-05-07 change diode
    [power.kicad_sch, versorlite.kicad_pcb]
2026-05-08 final jlcpcb update
    [BOM-versorlite.csv, power.kicad_sch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]
2026-05-08 Adjust naming
    [MCU.kicad_sch, versorlite.kicad_pcb]
2026-05-08 fix xt30
    [BOM-versorlite.csv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]
2026-05-27 update problem with build
    [versorlite.kicad_pcb]
2026-05-27 change board constraint trace width to 5 mil
2026-05-28 replace sensor to lsm6dsv320x
    [sensors.kicad_sch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]
2026-05-29 jlcpcb fixes
    [BOM-versorlite.csv, telemetry.kicad_sch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]
2026-05-30 Sync impedance requirement doc to git
    [Required_impedance_control.xlsx]
